alexander-sholohov/si4463-beacon/doc/WDS/README.md

Steps to program the frequency.

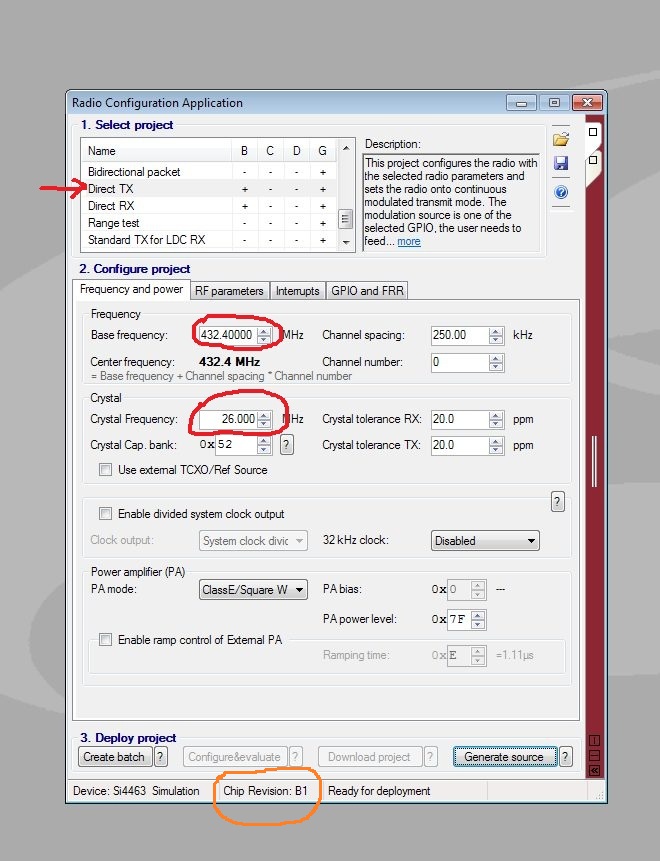
[picture p1: doc/WDS/img01.jpg]
WDS Step1

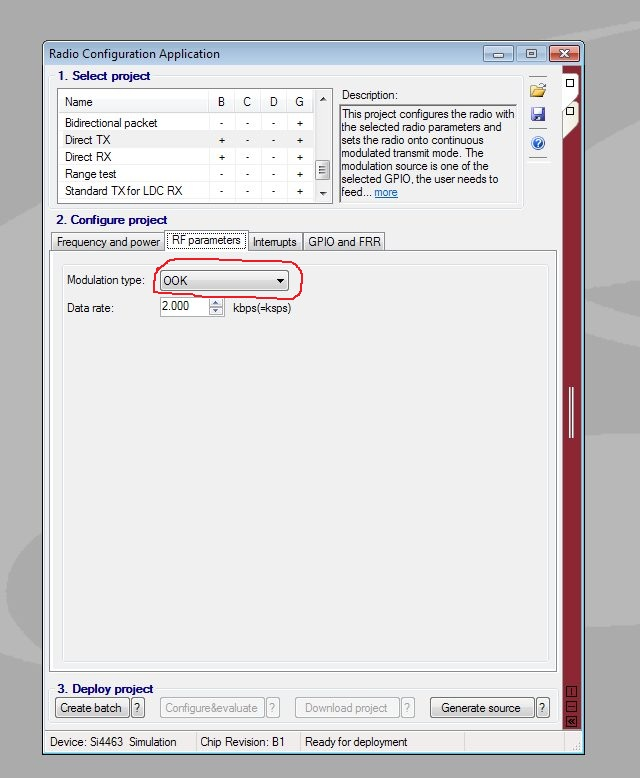
[picture p2: doc/WDS/img02.jpg]
WDS Step2

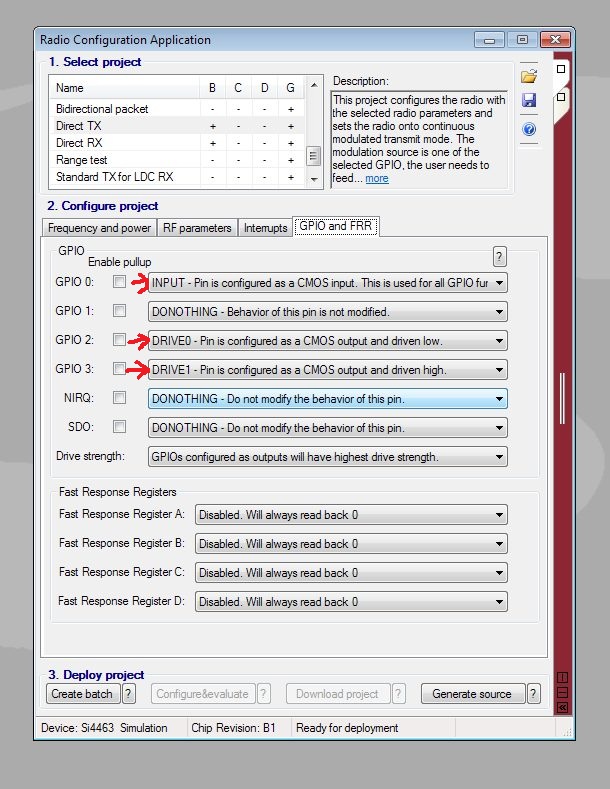
[picture p3: doc/WDS/img03.jpg]
WDS Step3

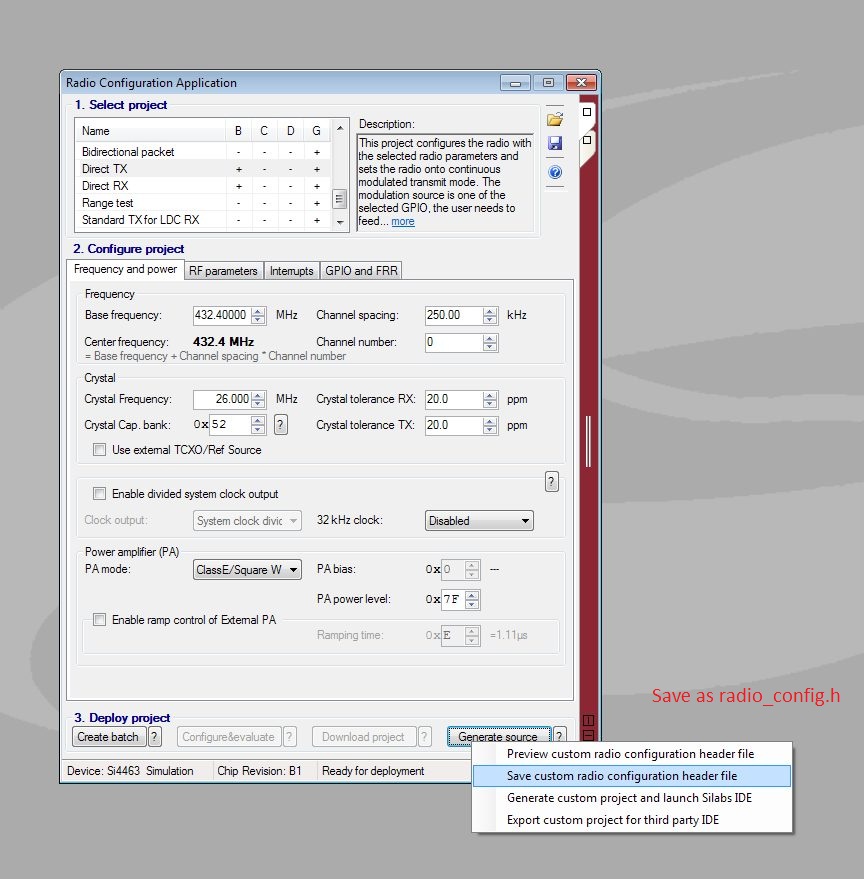
[picture p4: doc/WDS/img05.jpg]
WDS Step4
