alexander-sholohov/si4463-beacon/doc/layout.png

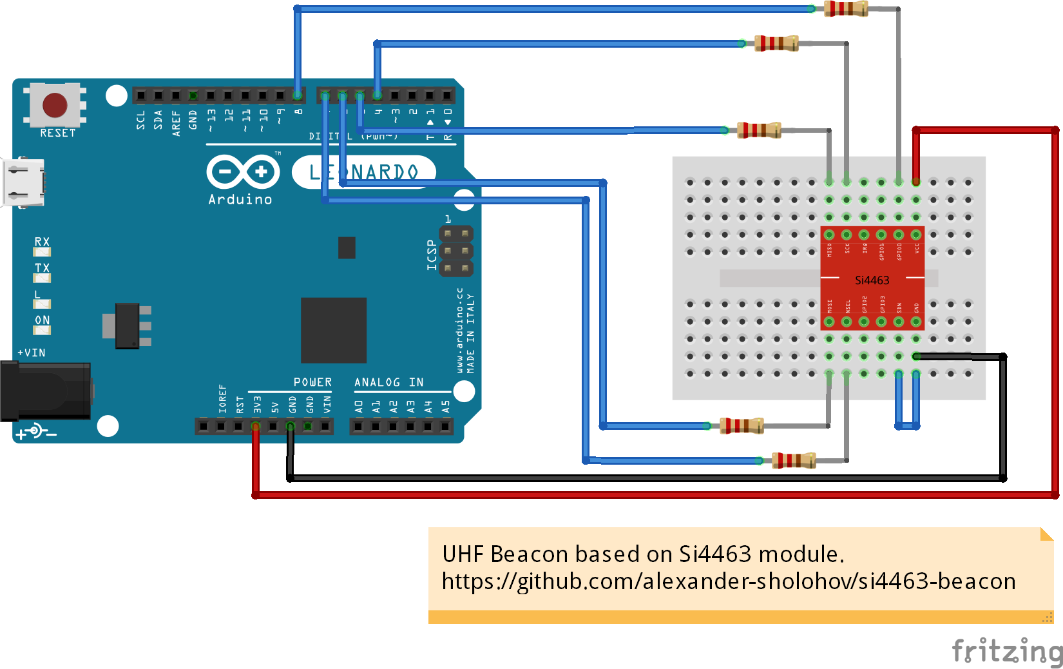
doc/layout.png
