alexander-sholohov/si4463-beacon/doc/photo/connected.jpg

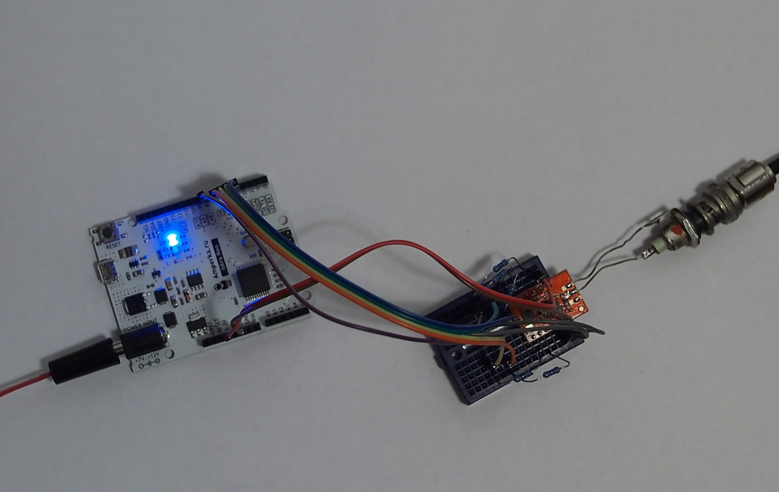
doc/photo/connected.jpg
