alexander-sholohov/si4463-beacon/doc/photo/si4463-module.jpg

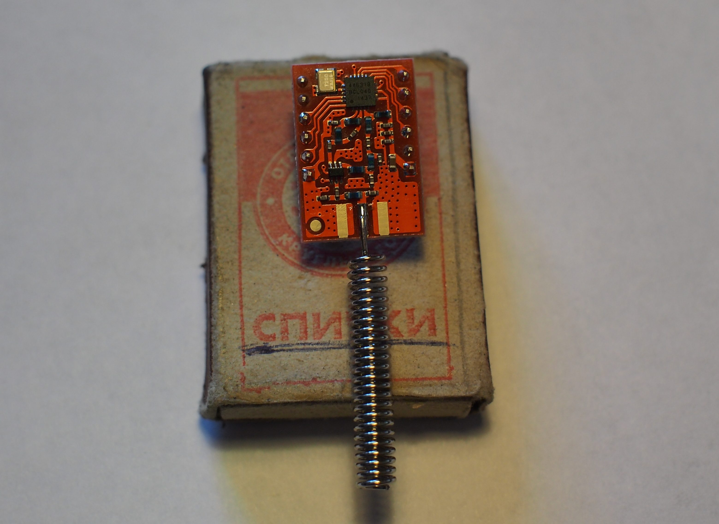
doc/photo/si4463-module.jpg
