alexander-sholohov/si4463-beacon/doc/schematic.png

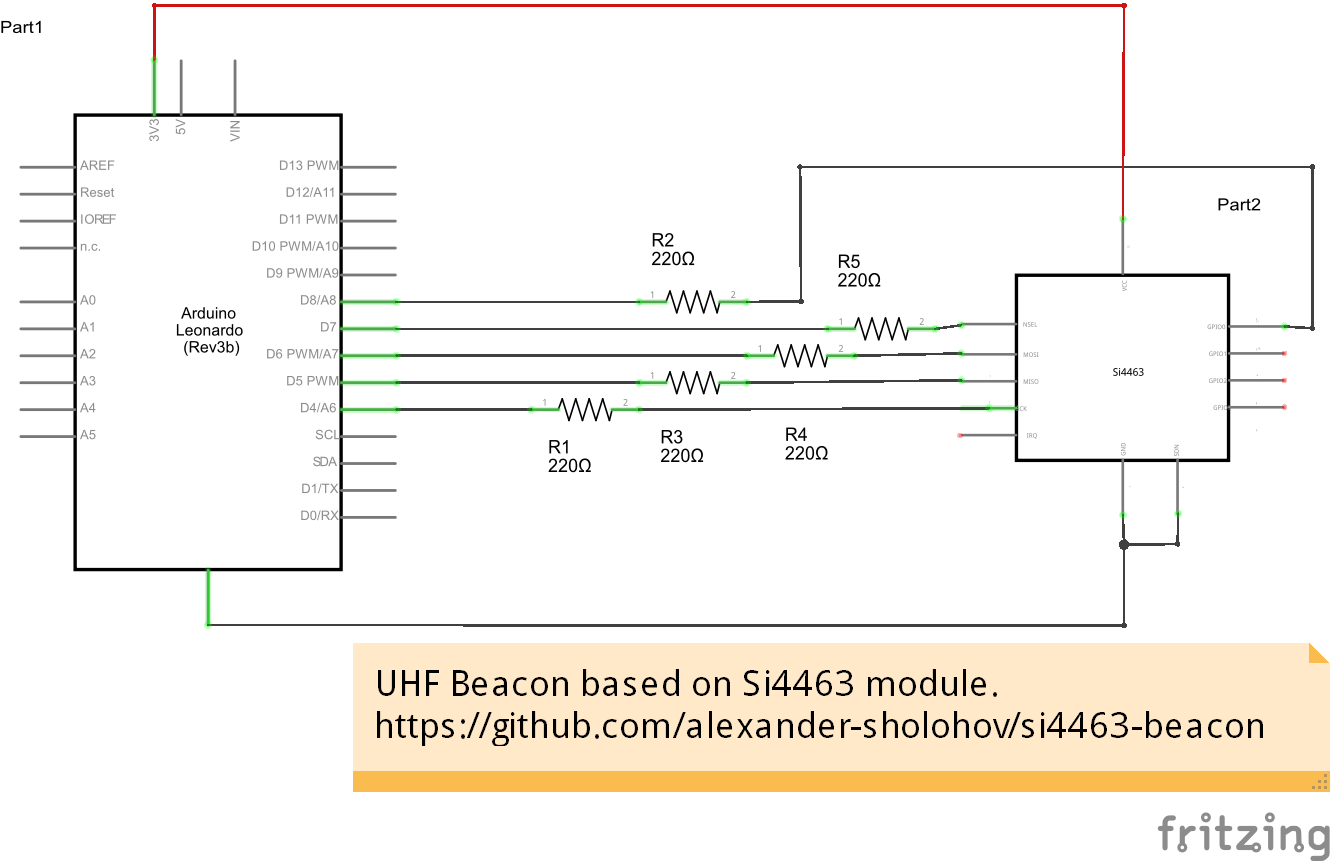
doc/schematic.png
