alexander-sholohov/si4463-beacon/(commit log)

2016-09-27 Adopted to Arduino 1.6.11
2017-05-25 NOP for Arduino DUE fixed
    [si4463.cpp]
